ETML-ES-SLO/PRJ_2411_SDSG/Doc/Annexes/Annexe N°2/2411_SDPSG-PLANNING_v1.pdf

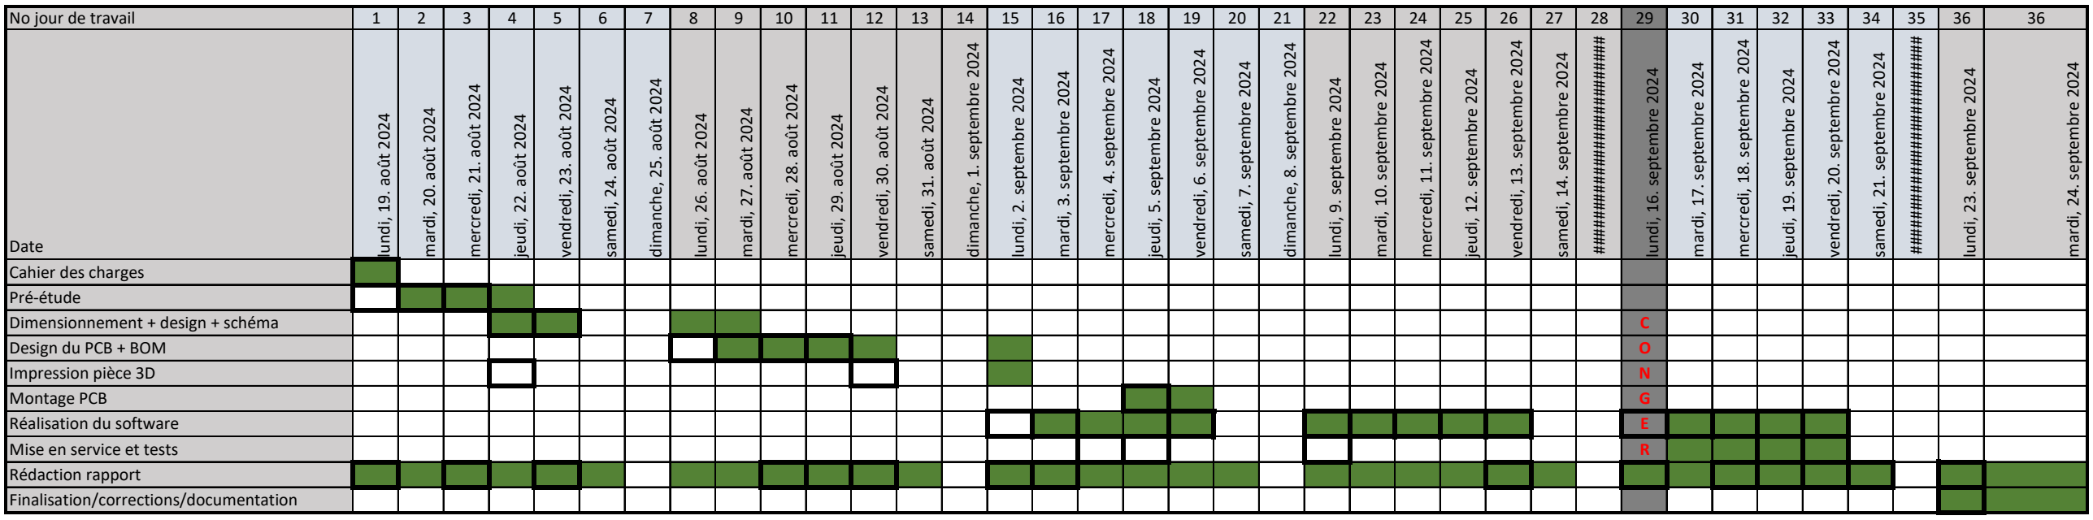
[picture p45: figure]
No jour de travail; Date; lundi, 19. août 2024; mardi, 20. août 2024; mercredi, 21. août 2024; jeudi, 22. août 2024; vendredi, 23. août 2024; samedi, 24. août 2024; dimanche, 25. août 2024; lundi, 26. août 2024; mardi, 27. août 2024; mercredi, 28. août 2024; jeudi, 29. août 2024; vendredi, 30. août 2024; samedi, 31. août 2024; dimanche, 1. septembre 2024; lundi, 2. septembre 2024; mardi, 3. septembre 2024; mercredi, 4. septembre 2024; jeudi, 5. septembre 2024; vendredi, 6. septembre 2024; samedi, 7. septembre 2024; dimanche, 8. septembre 2024; lundi, 9. septembre 2024; mardi, 10. septembre 2024; mercredi, 11. septembre 2024; jeudi, 12. septembre 2024; vendredi, 13. septembre 2024; samedi, 14. septembre 2024; lundi, 16. septembre 2024; mardi, 17. septembre 2024; mercredi, 18. septembre 2024; jeudi, 19. septembre 2024; vendredi, 20. septembre 2024; samedi, 21. septembre 2024; lundi, 23. septembre 2024; mardi, 24. septembre 2024; Cahier des charges Pré-étude Dimensionnement + design + schéma; Design du PCB + BOM; Impression pièce 3D; Montage PCB; Réalisation du software; Mise en service et tests; Rédaction rapport Finalisation/corrections/documentation
