ETML-ES-SLO/PRJ_2411_SDSG/Doc/Annexes/Annexe N°9/2411_SDPSG_Timer1_10ms.png

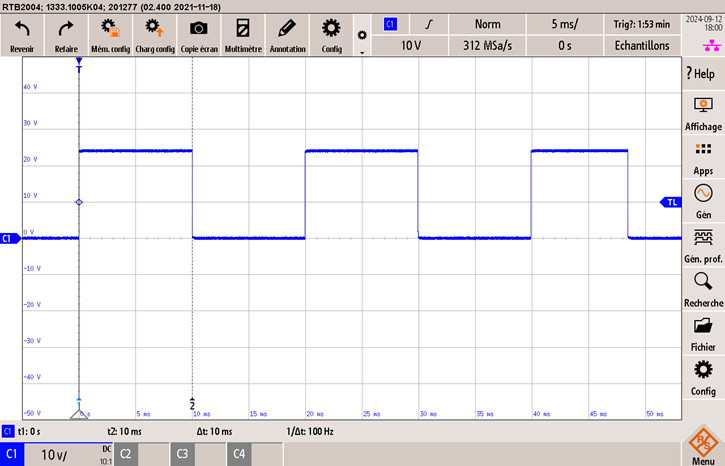
Doc/Annexes/Annexe N°9/2411_SDPSG_Timer1_10ms.png
