ETML-ES-SLO/PRJ_2411_SDSG/Doc/Annexes/Annexe N°13/DifferenceDOFAxes.PNG

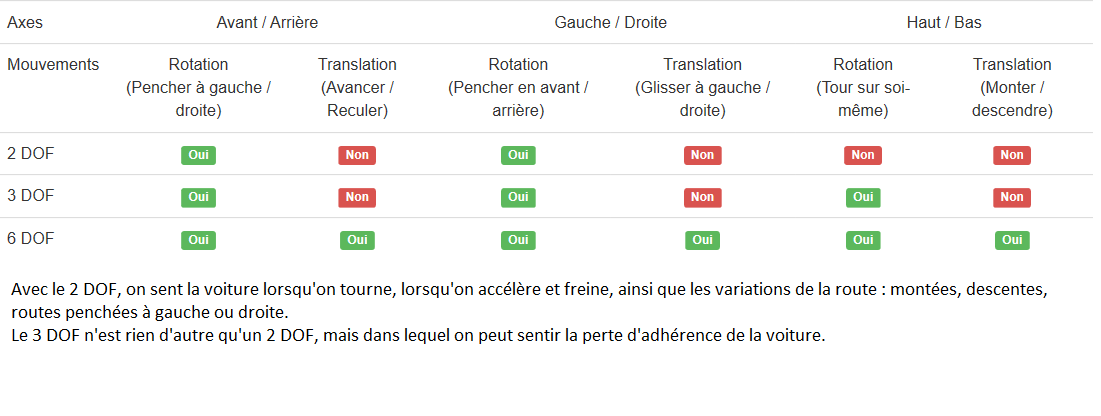
Doc/Annexes/Annexe N°13/DifferenceDOFAxes.PNG
