ETML-ES-SLO/PRJ_2411_SDSG/Doc/Images/ChangementPinProgrammable.png

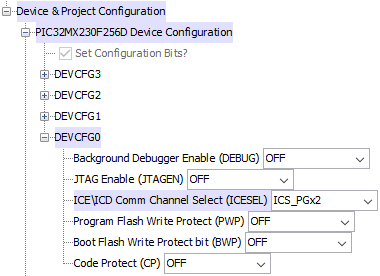
Doc/Images/ChangementPinProgrammable.png
