ETML-ES-SLO/PRJ_2411_SDSG/Doc/Images/Mesure Roue.jpg

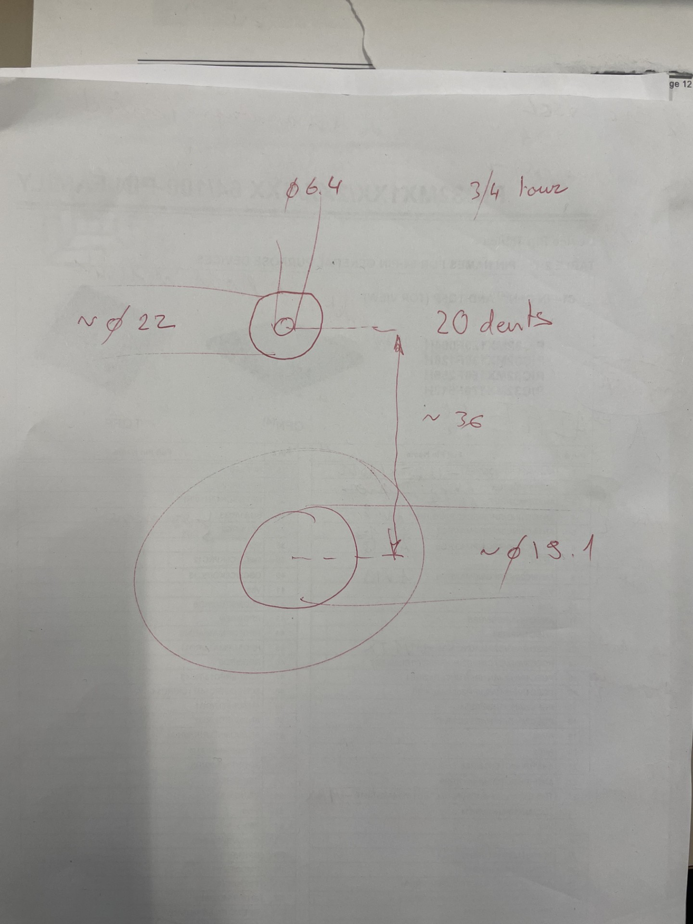
Doc/Images/Mesure Roue.jpg
