ETML-ES-SLO/PRJ_2411_SDSG/Doc/Images/Trame de Simtools/FinDeTrame.BMP

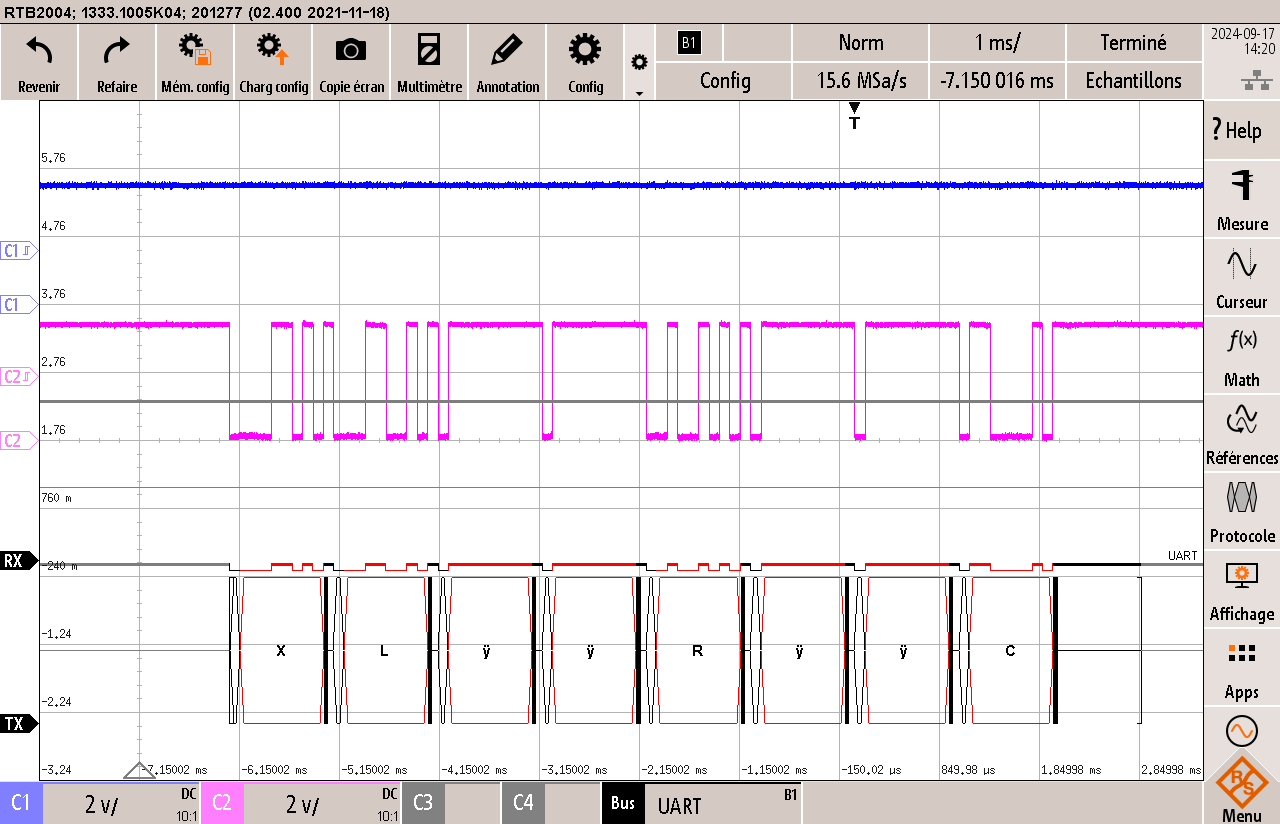
Doc/Images/Trame de Simtools/FinDeTrame.BMP
