ETML-ES-SLO/PRJ_2411_SDSG/Doc/Images/Trame de Simtools/TrameEnvoyeDonneeSimtools.PNG

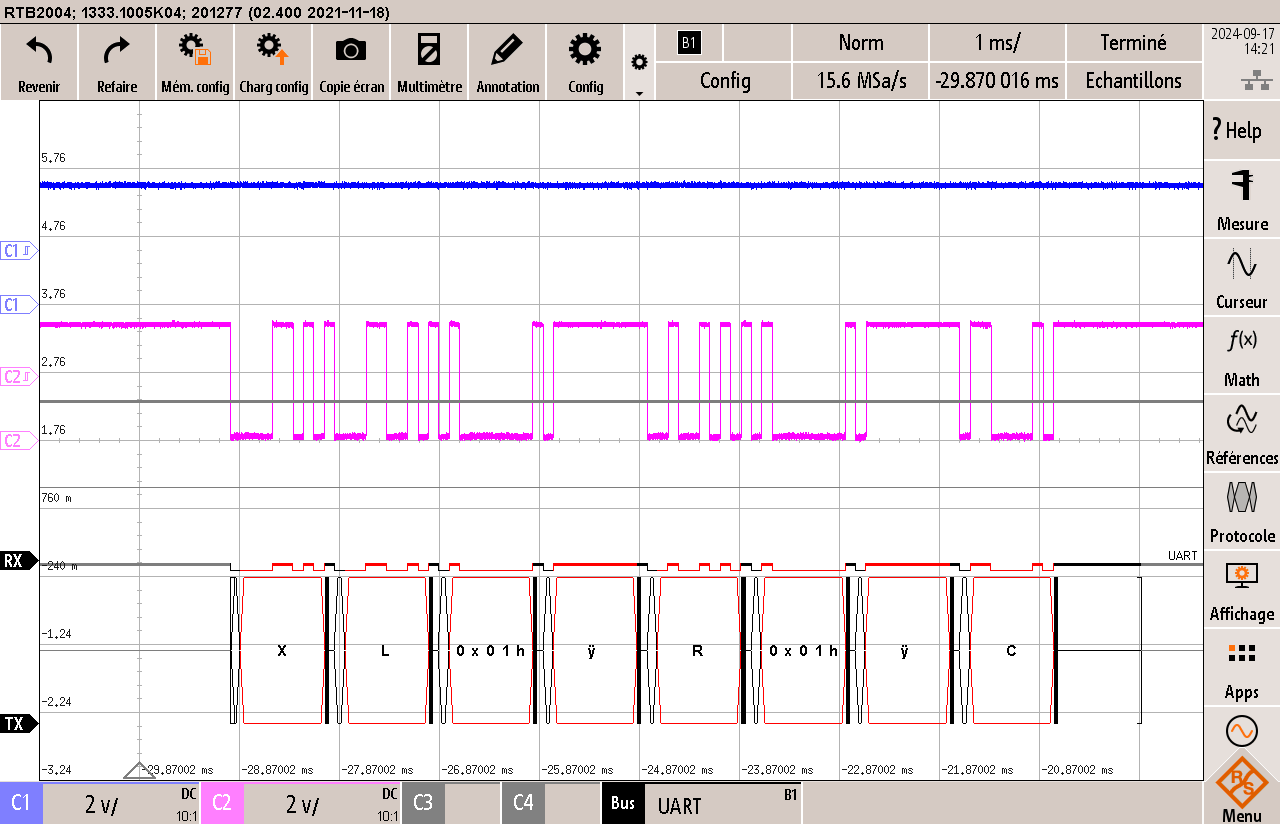
Doc/Images/Trame de Simtools/TrameEnvoyeDonneeSimtools.PNG
