ETML-ES-SLO/PRJ_2411_SDSG/Doc/Fichier fabrication pièces 3D/support_pot.stl

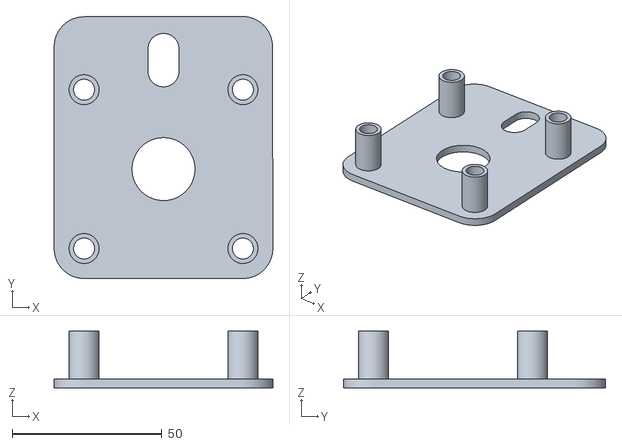
[picture p52: CAD file, 2024-09-24]
Doc/Fichier fabrication pièces 3D/support_pot.stl
73.0 x 87.4 x 19.0
