ETML-ES-SLO/PRJ_2411_SDSG/Doc/Fichier fabrication pièces 3D/Roue_Dents_Pot.stl

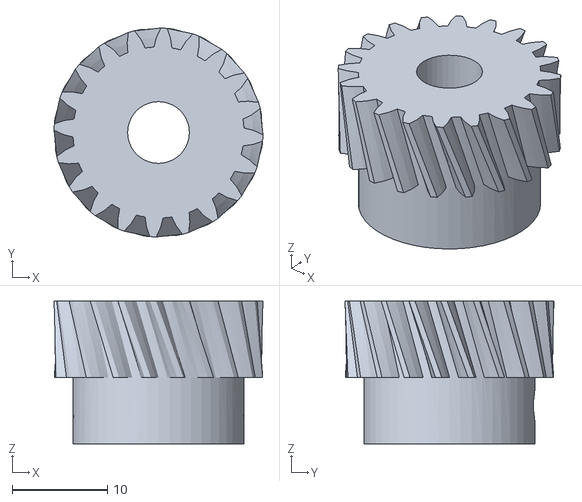
[picture p53: CAD file, 2024-09-24]
Doc/Fichier fabrication pièces 3D/Roue_Dents_Pot.stl
22.0 x 22.0 x 15.0
