ETML-ES-SLO/PRJ_2411_SDSG/Doc/Fichier fabrication pièces 3D/Roue_Dents_440W.STL

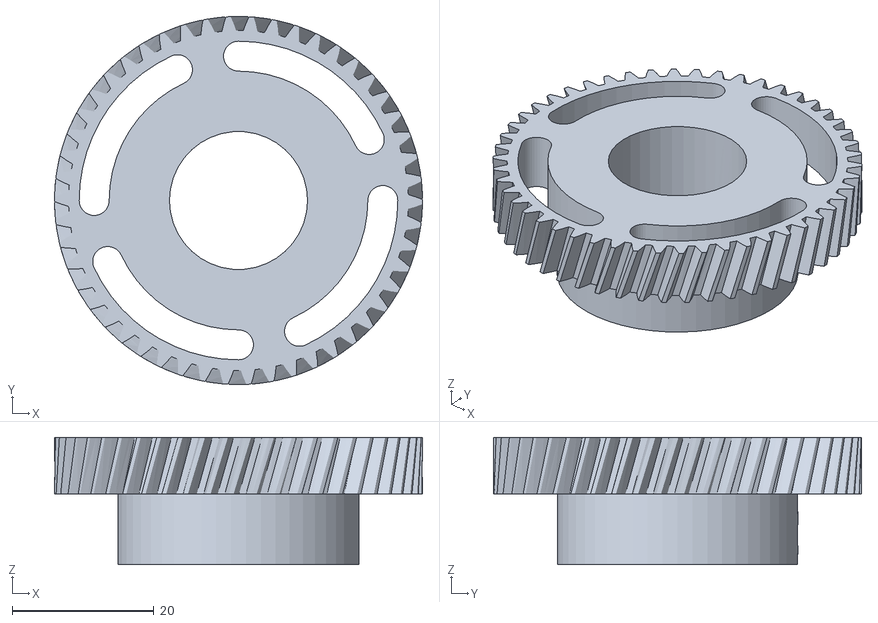
[picture p54: CAD file, 2024-09-24]
Doc/Fichier fabrication pièces 3D/Roue_Dents_440W.STL
52.0 x 52.0 x 18.0
