ETML-ES-SLO/PRJ_2411_SDSG/Doc/Annexes/Annexe N°12/Construction métallique/IMG_2528.PNG

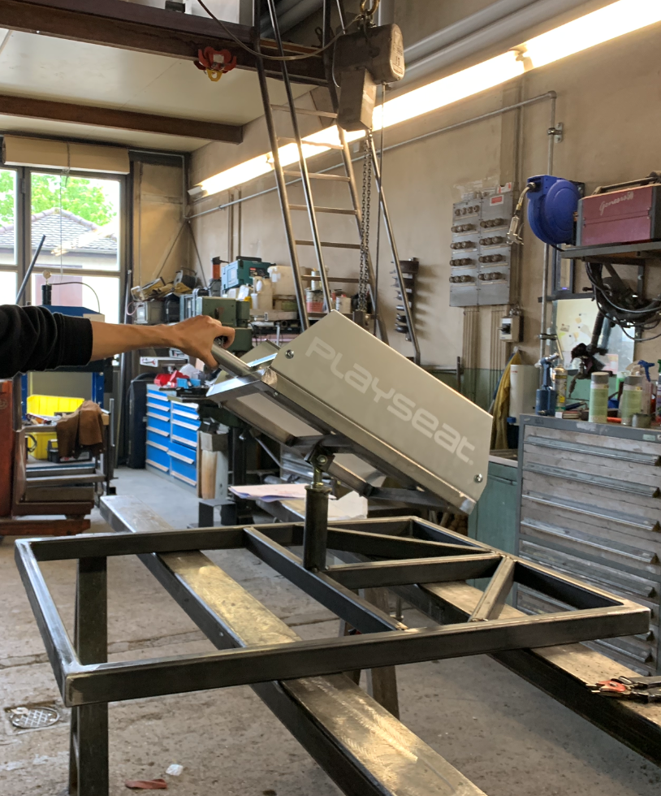
Doc/Annexes/Annexe N°12/Construction métallique/IMG_2528.PNG
