ETML-ES-SLO/PRJ_2411_SDSG/Doc/Annexes/Annexe N°12/Construction métallique/IMG_2882.jpg

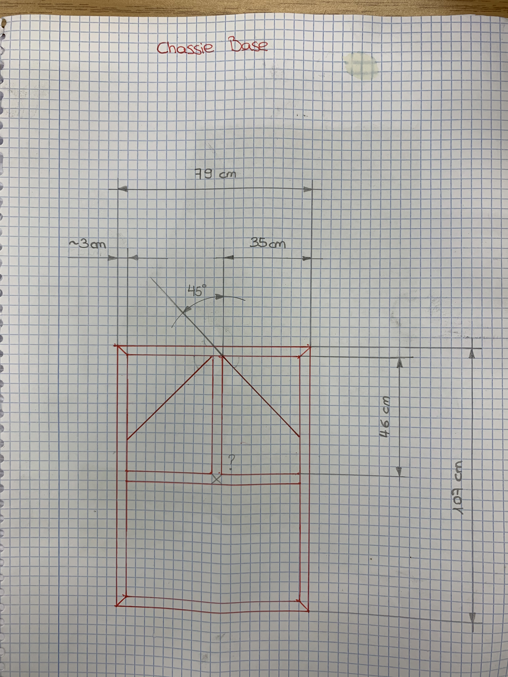
Doc/Annexes/Annexe N°12/Construction métallique/IMG_2882.jpg
