ETML-ES-SLO/PRJ_2411_SDSG/Doc/Protocole de test.xlsx

Protocole de test
Tâche n° | montage à braser | OK/NOK
1 | Alim 5V | OK | erreur au debut, montage diode (D1) inversé
2 | Alim 3.3V | OK
3 | uC | OK | test programmable OK
4 | Logic Level/cmd driver | OK
5 | Connecteur | OK | Test capteur OK, test pot OK (PIN config en ADC NOK)
6 | FT230XS | OK | Test communication avec Simtools OK
