ETML-ES-SLO/PRJ_2411_SDSG/Doc/Annexes/Annexe N°3/2411_SDPSG-JOURNAL_v1.xlsx

Jour | Date | Nbr période | Tâches effectuées
Lundi | 2024-08-19 | 7.66 | Validation CDC avec M.Gavin, plannification du projet et commencement pré-étude (donnée envoyée par simtools, caractéristiques du moteur et utilisation du driver moteur)
Mardi | 2024-08-20 | 10 | Choix de tout les composants primaires
Mercredi | 2024-08-21 | 10 | Rédaction de la pré-étude dans le rapport ainsi que prise d'information pour certains composants
Jeudi | 2024-08-22 | 10 | Schématic
Vendredi | 2024-08-23 | 10 | Fini schématic, revue de schéma fait par DBS, continuation rapport
Samedi | 2024-08-24 | -
Dimanche | 2024-08-25 | -
Lundi | 2024-08-26 | 8.5 | Test de mes pieces 3D avec le moteur ainsi que le driver. Test alim 24V / 40A que je vais surement utiliser. Commencement PCB
Mardi | 2024-08-27 | 12 | Revu schéma avec M. Gavin, modification Schématic et avancement PCB
Mercredi | 2024-08-28 | 8.5 | Fini PCB, revue du PCB fait par JAR. Vérification EuroCircuit OK (Classe 6C), vérification composant pour les commander. Avancement rapport.
Jeudi | 2024-08-29 | 11.5 | Modification du PCB après revue faite par M. Gavin (M. Moreno ma aussi fait part de quelques améliorations sur mon PCB), création BOM et mis en commande des composants et finition PCB.
Vendredi | 2024-08-30 | 9 | Avancement rapport, mise en production de mes pièces 3D.
Samedi | 2024-08-31 | -
Dimanche | 2024-09-01 | -
Lundi | 2024-09-02 | 10 | Avancement rapport, création du projet avec mplab x, création diagramme du code, création du structogramme et configuration de l'ordinateur de jeu.
Mardi | 2024-09-03 | 9 | Rapport, avancement programmation (ADC), test du sabertooth avc DEScribe.
Mercredi | 2024-09-04 | 11.5 | Avancement programmation, mise en place de ma structure métalique avec les moteurs et je les ai tester avec une alimention pour voir les mouvements de ma plateforme.
Jeudi | 2024-09-05 | 13.33 | Installation de simtools et voir le fonctionnement (impossible de communiquer en serial avec la V3 du coup j'ai du installer la V2.4 mais le plugin du jeu ne fonctionnait plus, jai du trouver une ancienne version du plugin), brasage des composants
Vendredi | 2024-09-06 | 12 | Création librairie pour le gyroscope mais je ne sais pas pourquoi sa ne fonctionne pas pourtant je viens dans les bon registres. Créations librairie pour mes capteurs ( modification a faire pour être plus precis).
Samedi | 2024-09-07 | -
Dimanche | 2024-09-08 | -
Lundi | 2024-09-09 | 12 | Nouvelle approches pour mes capteurs (coupé la courbe en 4 pentes afin detre le plus précis possible), lecture de mes pots (config en AN0/1 ne fonctionne pas), mise en place de mes Ocs, finission montage mecanique
Mardi | 2024-09-10 | 9 | Configuration et test Driver moteur, essayer de communiquer via simtools mais je ne recevais rien
Mercredi | 2024-09-11 | 10 | Communication avec simtools OKAY décodage trame, programmation du gyroscope mais toujours non-fonctionnel, Test de mes 2 pots et des 4 capteur de distance OK.
Jeudi | 2024-09-12 | 13 | Programmation interrupt de uart, Trame envoyer par simtools recu sur l'usart et protection mise en place.
Vendredi | 2024-09-13 | 10.5 | Programmation fonction pour les pots. Avancement rapport
Samedi | 2024-09-14 | -
Dimanche | 2024-09-15 | -
Lundi | 2024-09-16 | 10 | Programmation du PID, fonction Limite, fonction ReMapping + algorithme de gestion du moteur sauf que je ne peux rien tester car je n'ai pas recu les pièces en 3D . Et rapport
Mardi | 2024-09-17 | 10 | Avancement programmation et rapport
Mercredi | 2024-09-18 | 12 | Avancement rapport et j'ai mis en fabrication mes pièce 3D à l'ETML car à l'ETML-ES sa n'avancais pas..
Jeudi | 2024-09-19 | 15 | J'ai enfin recu mes pièces 3D, du coup j'ai pu remonter ma structure avec les jeux de roues dentées ce qui ma permis de voir que le code n'allait pas. Amélioration du code
Vendredi | 2024-09-20 | 15 | Probleme lors du démarrage de ma carte car les pins des oc seront activé dans un état flottant ce qui fait bouger les moteurs donc perdre le point de repère.
Samedi | 2024-09-21 | 12 | Avancement du rapport
Dimanche | 2024-09-22
Lundi | 2024-09-23 | 13 | Finition rapport + impression de tout les documents utiles
Mardi | 2024-09-24 |  | Rendu du rapport et de ses annexes.
