ETML-ES-SLO/PRJ_2411_SDSG/Doc/Annexes/Annexe N°5/2411_SDPSG_Schematic_PCB_v1.pdf

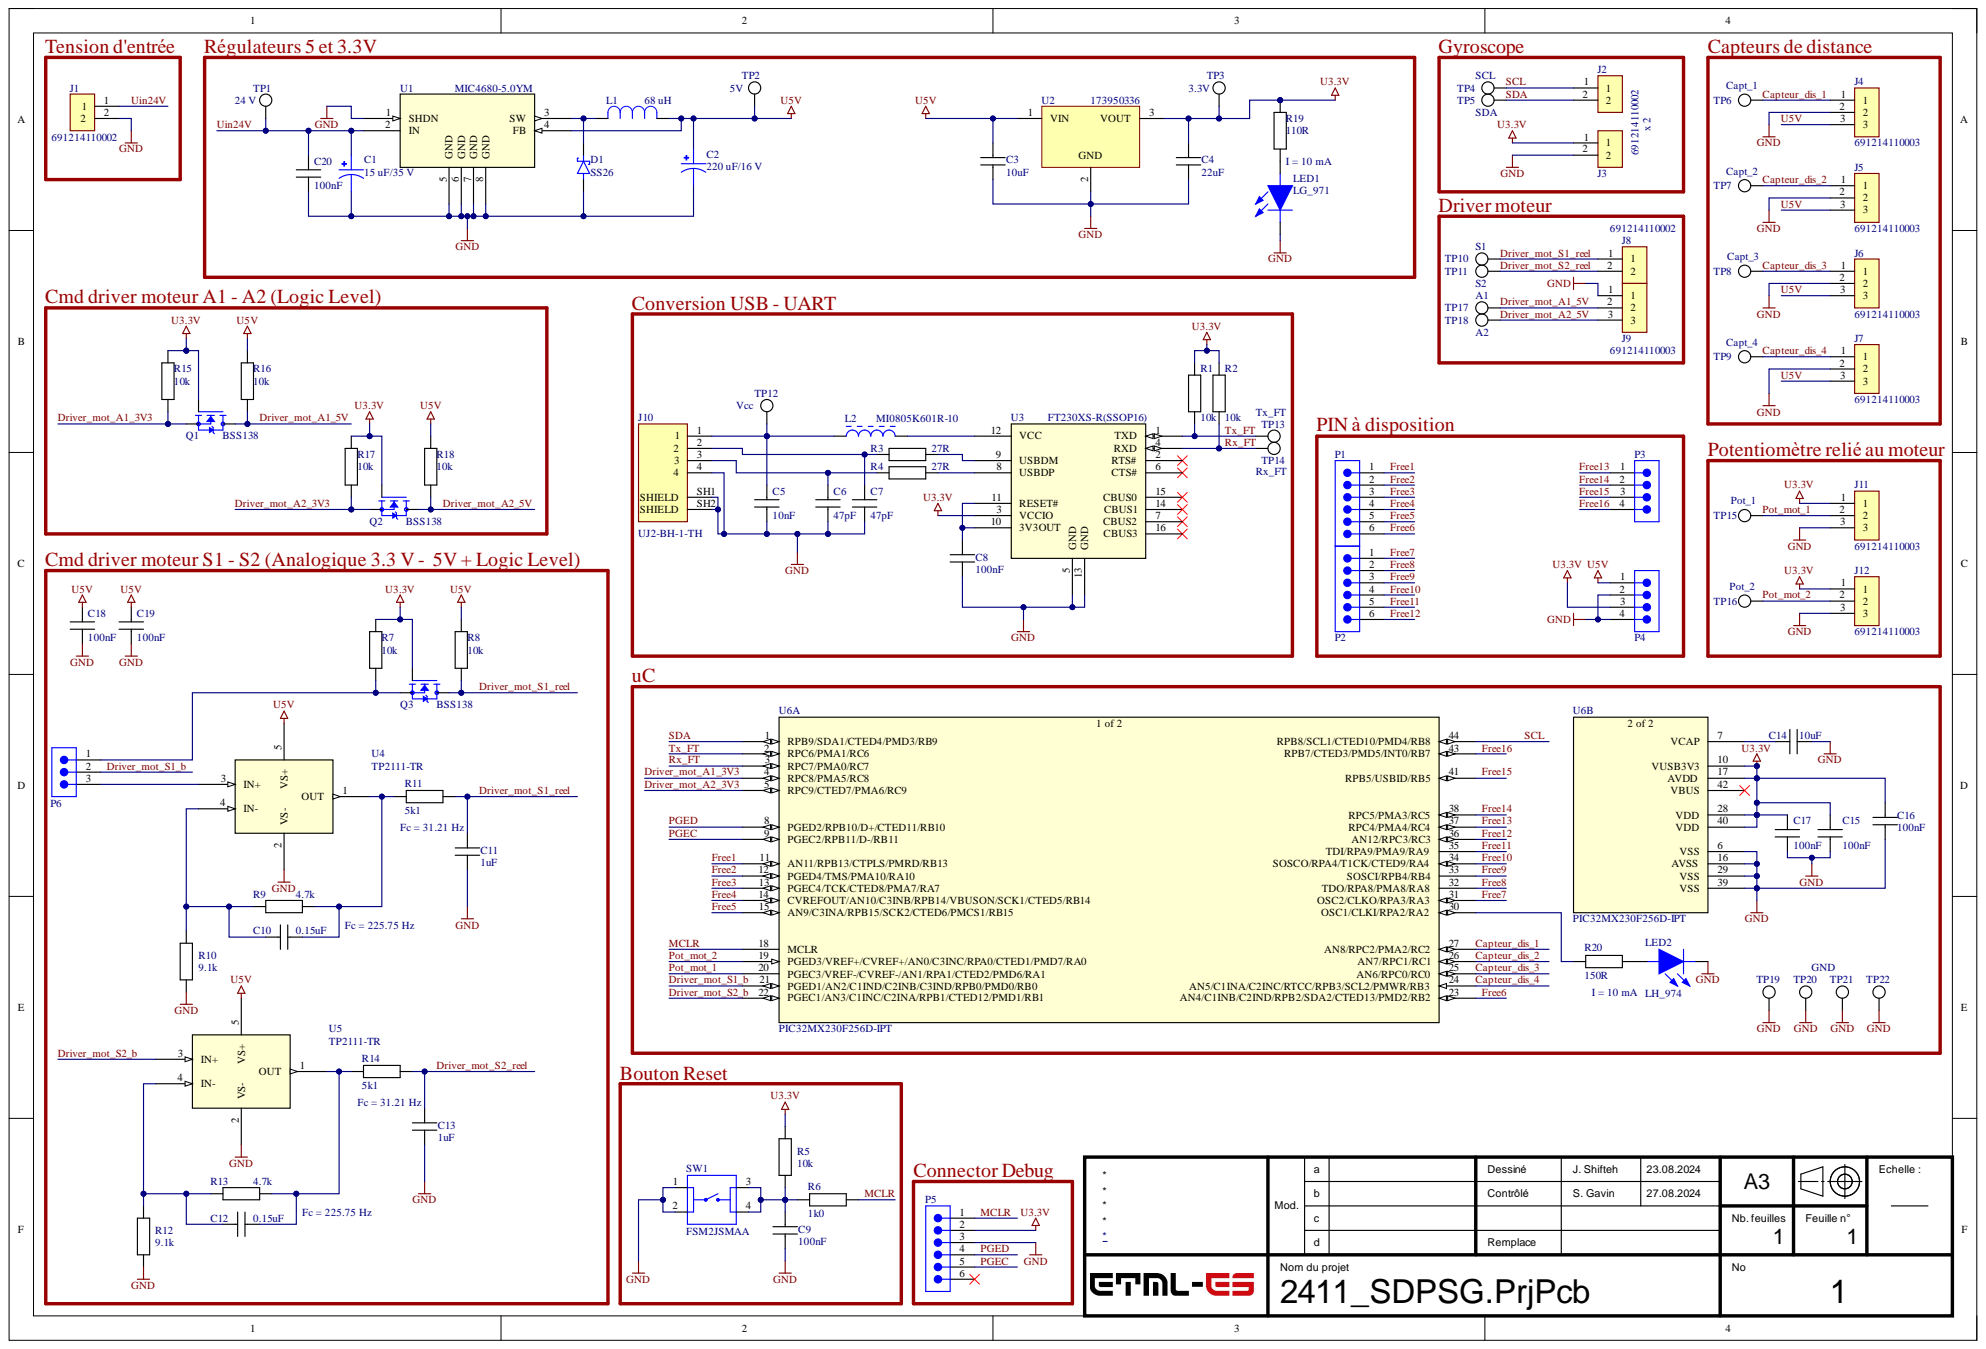
[picture p62: page 1]

Cmd driver moteur A1 - A2 (Logic Level)

Potentiomètre relié au moteur

Cmd driver moteur S1 - S2 (Analogique 3.3 V - 5V + Logic Level)

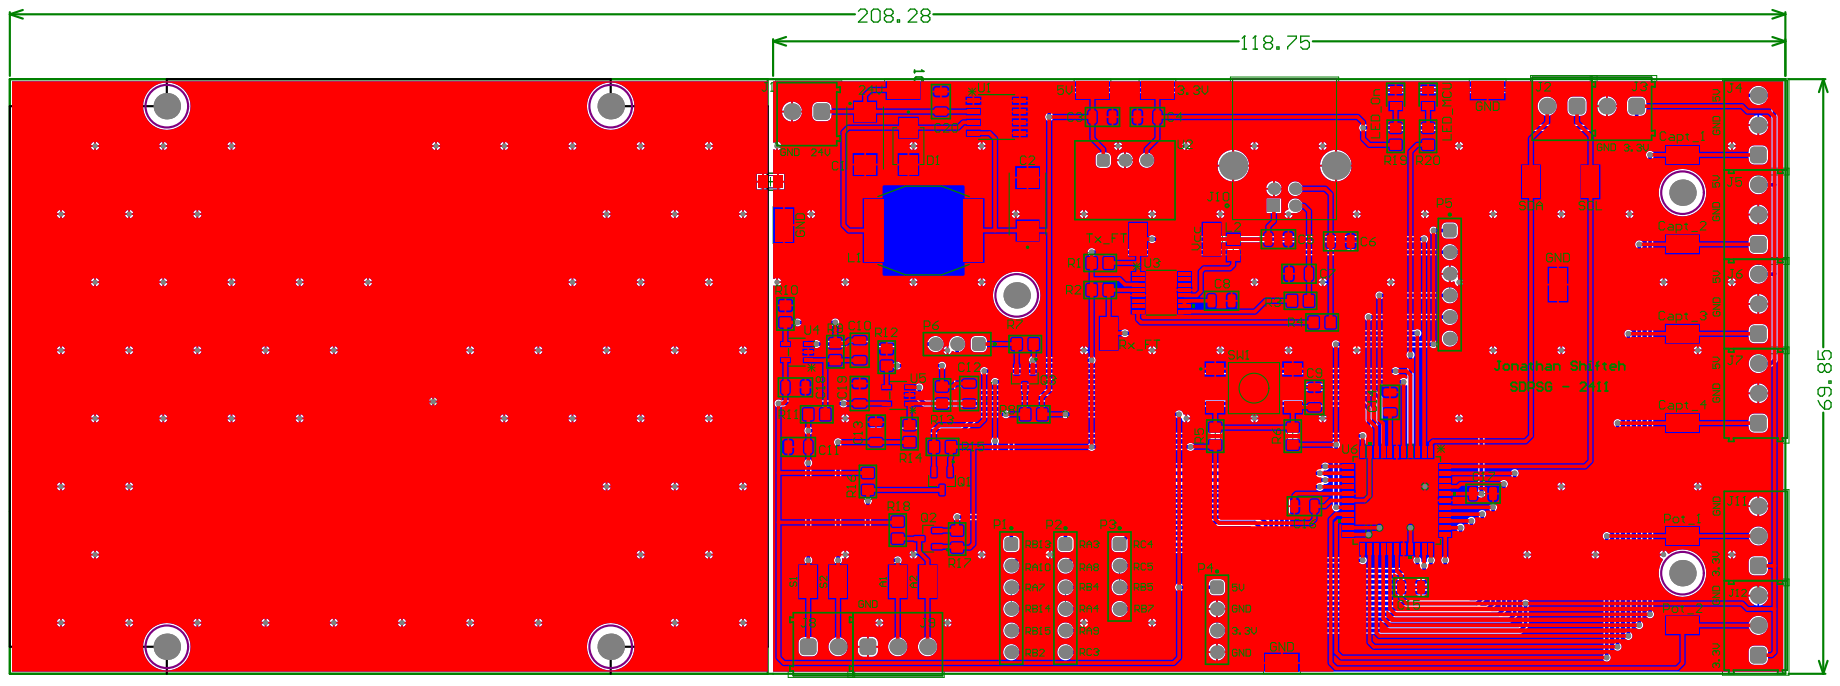
[picture p63: page 2]
