ETML-ES-SLO/PRJ_2411_SDSG/Doc/Annexes/Annexe N°6/2411_SDPSG_PCB Top-Bot Assy Dwgs_Variant_v1.PDF

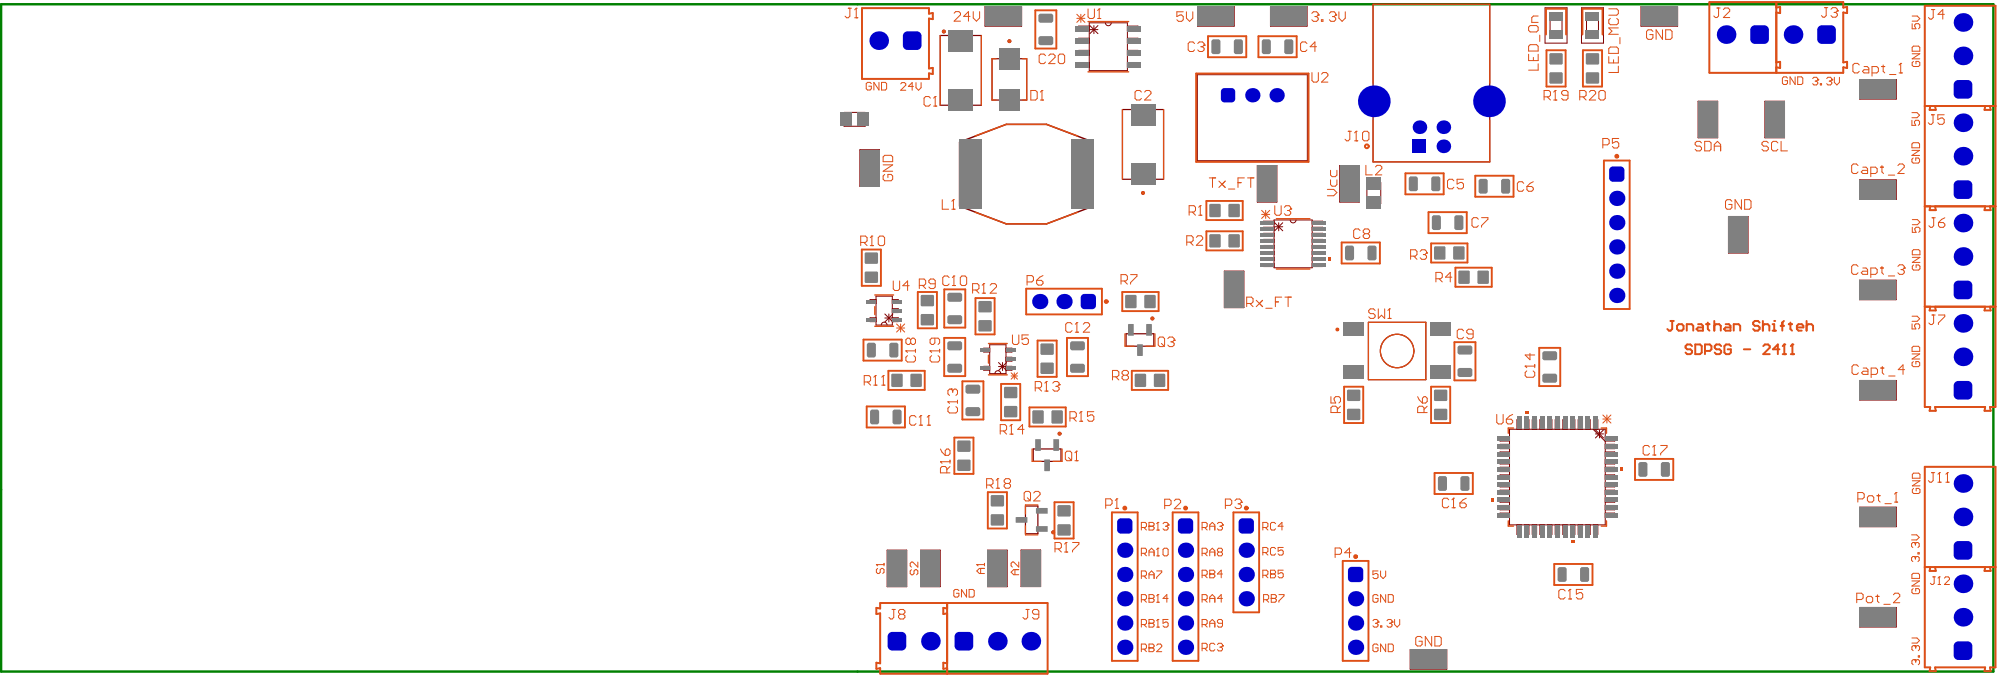
[picture p64: page 1]

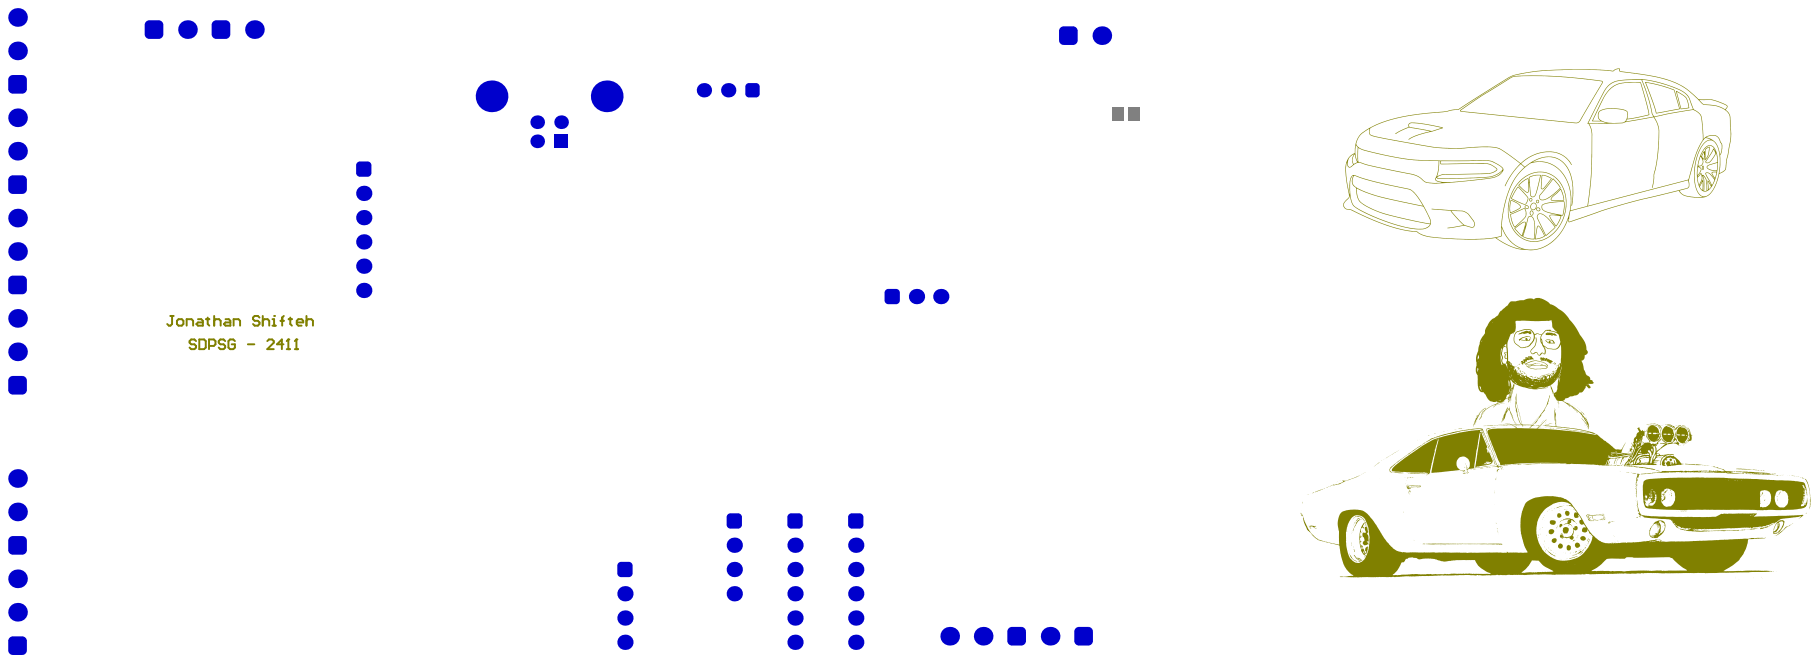
[picture p65: page 2]
